tomas-condo/tdse-tf_2-02_/main.c

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
/* Includes ------------------------------------------------------------------*/
#include "main.h"

/* USER CODE BEGIN Includes */

/* Application includes. */
#include "logger.h"
#include "app.h"

/* USER CODE END Includes */

/* USER CODE BEGIN PD */

ADC_HandleTypeDef hadc1;

I2C_HandleTypeDef hi2c1;

TIM_HandleTypeDef htim3;

UART_HandleTypeDef huart2;

void SystemClock_Config(void);
static void MX_GPIO_Init(void);
static void MX_USART2_UART_Init(void);
static void MX_ADC1_Init(void);
static void MX_I2C1_Init(void);
static void MX_TIM3_Init(void);
/* USER CODE BEGIN 0 */
#if (1 == LOGGER_CONFIG_USE_SEMIHOSTING)

extern void initialise_monitor_handles(void);

#endif

/* USER CODE END 0 */

/**
  * @brief  The application entry point.
  * @retval int
  */
int main(void)
{

  /* USER CODE BEGIN 1 */
  #if (1 == LOGGER_CONFIG_USE_SEMIHOSTING)

  initialise_monitor_handles();

  #endif

  /* USER CODE END 1 */

  /* MCU Configuration--------------------------------------------------------*/

  /* Reset of all peripherals, Initializes the Flash interface and the Systick. */
  HAL_Init();

  /* Configure the system clock */
  SystemClock_Config();

  /* Initialize all configured peripherals */
  MX_GPIO_Init();
  MX_USART2_UART_Init();
  MX_ADC1_Init();
  MX_I2C1_Init();
  MX_TIM3_Init();
  /* USER CODE BEGIN 2 */

	/* Application Init */
	app_init();

  /* USER CODE END 2 */

  /* Infinite loop */
  /* USER CODE BEGIN WHILE */
  while (1)
  {
    /* USER CODE END WHILE */

    /* USER CODE BEGIN 3 */

    /* Application Update */
    app_update();

    // DORMIR CPU (BAJO CONSUMO)
    HAL_PWR_EnterSLEEPMode(PWR_MAINREGULATOR_ON, PWR_SLEEPENTRY_WFI);

  }
  /* USER CODE END 3 */
}

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
/* USER CODE BEGIN 4 */

// --- STUBS PARA ARREGLAR ERROR DEL LINKER (_kill) ---
#include <sys/stat.h>

int _getpid(void) {
    return 1;
}

int _kill(int pid, int sig) {
    return -1;
}


/* USER CODE END 4 */
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
