tomas-condo/tdse-tf_2-02_/main.h

#define B1_Pin GPIO_PIN_13
#define B1_GPIO_Port GPIOC
#define B1_EXTI_IRQn EXTI15_10_IRQn
#define BOTON_AZ_Pin GPIO_PIN_1
#define BOTON_AZ_GPIO_Port GPIOC
#define BOTON_AM_Pin GPIO_PIN_2
#define BOTON_AM_GPIO_Port GPIOC
#define USART_TX_Pin GPIO_PIN_2
#define USART_TX_GPIO_Port GPIOA
#define USART_RX_Pin GPIO_PIN_3
#define USART_RX_GPIO_Port GPIOA
#define LD2_Pin GPIO_PIN_5
#define LD2_GPIO_Port GPIOA
#define D7_Pin GPIO_PIN_11
#define D7_GPIO_Port GPIOB
#define D6_Pin GPIO_PIN_12
#define D6_GPIO_Port GPIOB
#define D9_Pin GPIO_PIN_6
#define D9_GPIO_Port GPIOC
#define D8_Pin GPIO_PIN_8
#define D8_GPIO_Port GPIOC
#define D5_Pin GPIO_PIN_11
#define D5_GPIO_Port GPIOA
#define D4_Pin GPIO_PIN_12
#define D4_GPIO_Port GPIOA
#define TMS_Pin GPIO_PIN_13
#define TMS_GPIO_Port GPIOA
#define TCK_Pin GPIO_PIN_14
#define TCK_GPIO_Port GPIOA
#define BOTON_RO_Pin GPIO_PIN_10
#define BOTON_RO_GPIO_Port GPIOC
#define BOTON_VE_Pin GPIO_PIN_2
#define BOTON_VE_GPIO_Port GPIOD
#define SWO_Pin GPIO_PIN_3
#define SWO_GPIO_Port GPIOB
