tomas-condo/tdse-tf_2-02_/task_gameplay_interface.c

/********************** inclusions *******************************************/
/* Project includes */
#include "main.h"

/* Demo includes */
#include "logger.h"
#include "dwt.h"

/* Application & Tasks includes */
#include "board.h"
#include "app.h"
#include "task_gameplay_attribute.h"

/********************** macros and definitions *******************************/
#define EVENT_UNDEFINED	(255)
#define MAX_EVENTS		(16)

/********************** internal data declaration ****************************/

/********************** internal functions declaration ***********************/

/********************** internal data definition *****************************/
struct
{
	uint32_t	head;
	uint32_t	tail;
	uint32_t	count;
	task_gameplay_ev_t	queue[MAX_EVENTS];
} queue_task_g;

/********************** external data declaration ****************************/

/********************** external functions definition ************************/
void init_queue_event_task_gameplay(void)
{
	uint32_t i;

	queue_task_g.head = 0;
	queue_task_g.tail = 0;
	queue_task_g.count = 0;

	for (i = 0; i < MAX_EVENTS; i++)
		queue_task_g.queue[i] = EVENT_UNDEFINED;
}

void put_event_task_gameplay(task_gameplay_ev_t event)
{
	queue_task_g.count++;
	queue_task_g.queue[queue_task_g.head++] = event;

	if (MAX_EVENTS == queue_task_g.head)
		queue_task_g.head = 0;
}

task_gameplay_ev_t get_event_task_gameplay(void)
{
	task_gameplay_ev_t event;

	queue_task_g.count--;
	event = queue_task_g.queue[queue_task_g.tail];
	queue_task_g.queue[queue_task_g.tail++] = EVENT_UNDEFINED;

	if (MAX_EVENTS == queue_task_g.tail)
		queue_task_g.tail = 0;

	return event;
}

bool any_event_task_gameplay(void)
{
  return (queue_task_g.head != queue_task_g.tail);
}

/********************** end of file ******************************************/
