tomas-condo/tdse-tf_2-02_/(commit log)

2026-02-19 Entrega Definitiva
    [tdse-tf_2-02 Debug.cfg, tdse-tf_2-02.cfg]
2026-02-20 Correcciones
    Se arregló definitivamente el índice.
